rhijnvanderweel-art/O-en-o-suikerziekte-3d-model/images/back_side.png

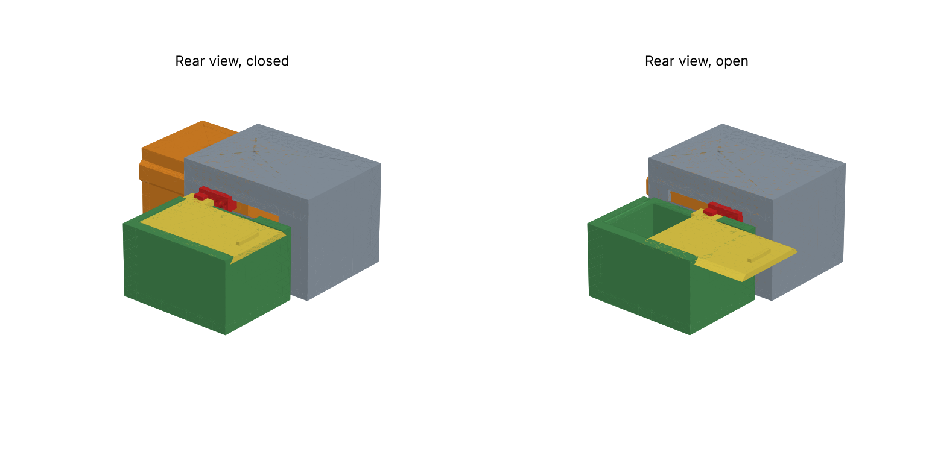
images/back_side.png
