rhijnvanderweel-art/O-en-o-suikerziekte-3d-model/images/top.png

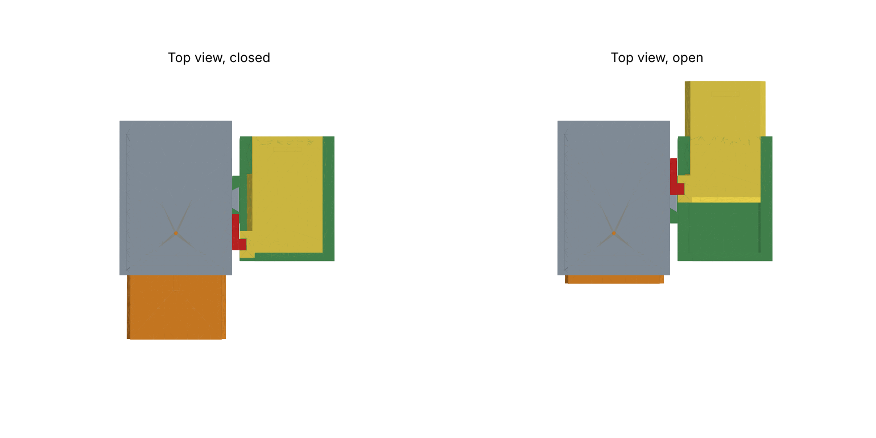
images/top.png
