rhijnvanderweel-art/O-en-o-suikerziekte-3d-model/step/assembly_open.step

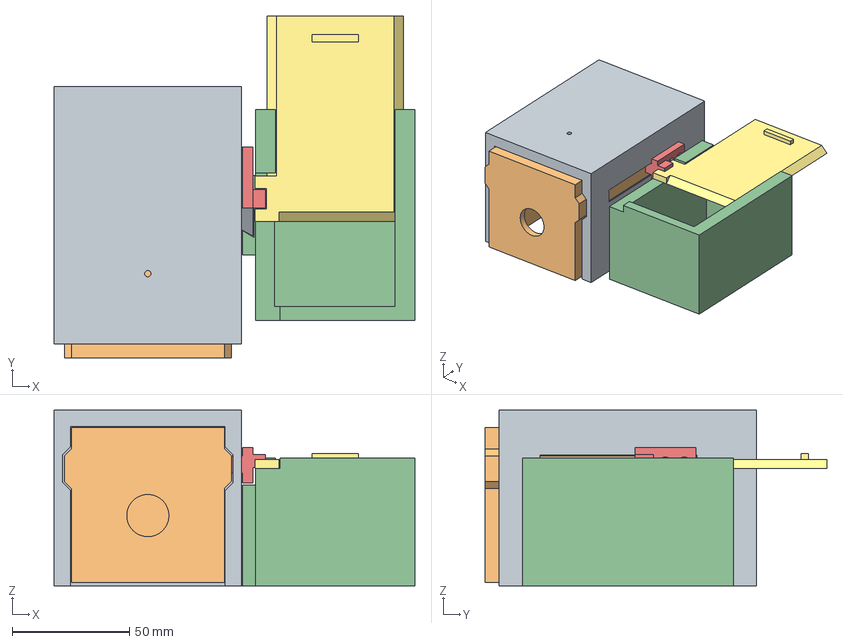
[picture p5: CAD file, 2026-11-12]
step/assembly_open.step
154.0 x 146.0 x 75.0 mm
driver
bin
lid
