rhijnvanderweel-art/O-en-o-suikerziekte-3d-model/step/assembly_closed.step

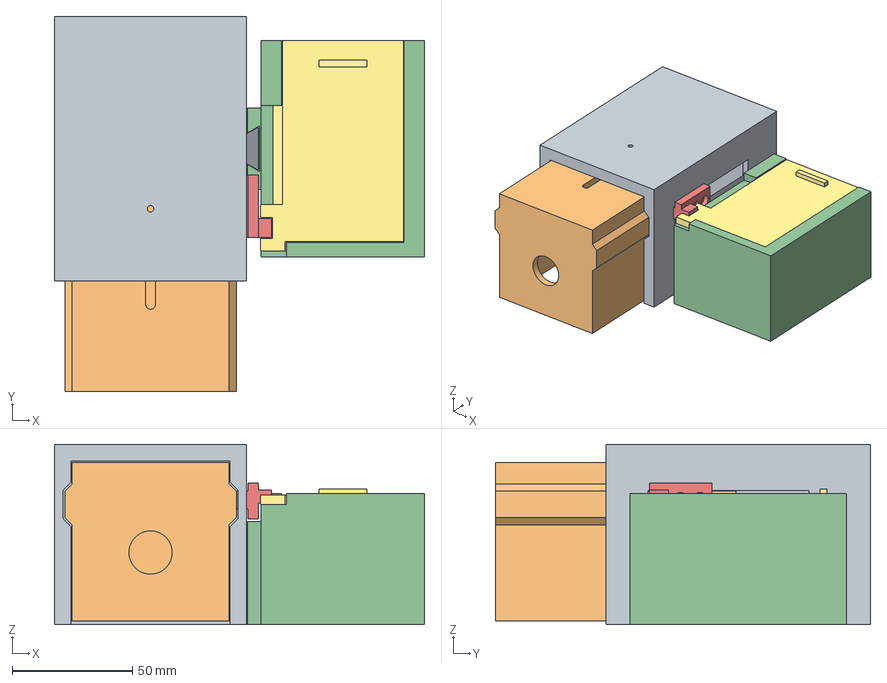
[picture p6: CAD file, 2026-11-12]
step/assembly_closed.step
154.0 x 156.0 x 75.0 mm
driver
bin
lid
