rhijnvanderweel-art/O-en-o-suikerziekte-3d-model/stl/3_driver.stl

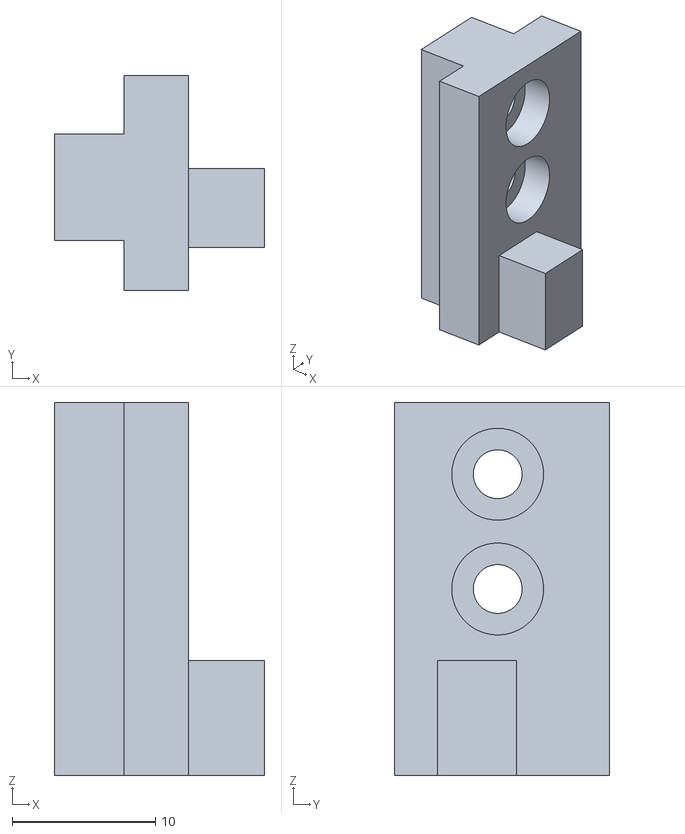
[picture p7: CAD file, 2026-11-12]
stl/3_driver.stl
14.6 x 15.0 x 26.0
