rhijnvanderweel-art/O-en-o-suikerziekte-3d-model/stl/4_bin.stl

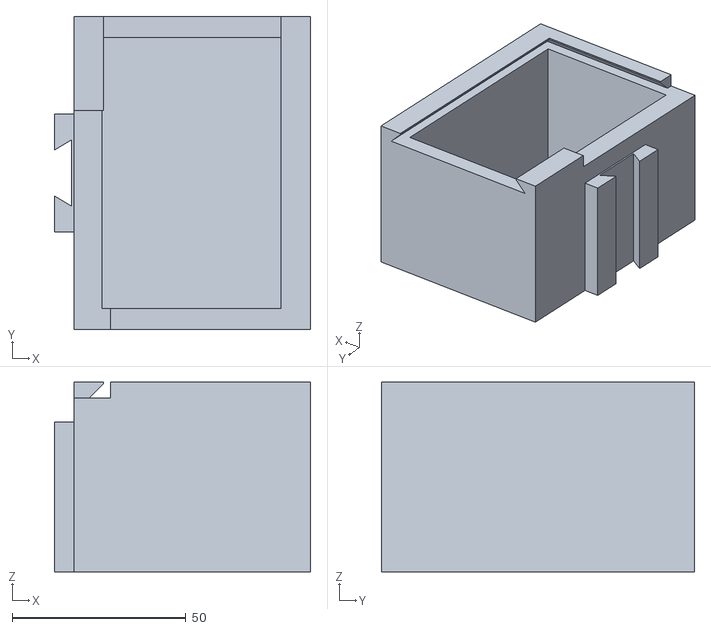
[picture p8: CAD file, 2026-11-12]
stl/4_bin.stl
73.6 x 90.0 x 54.5
