rhijnvanderweel-art/O-en-o-suikerziekte-3d-model/stl/1_shell.stl

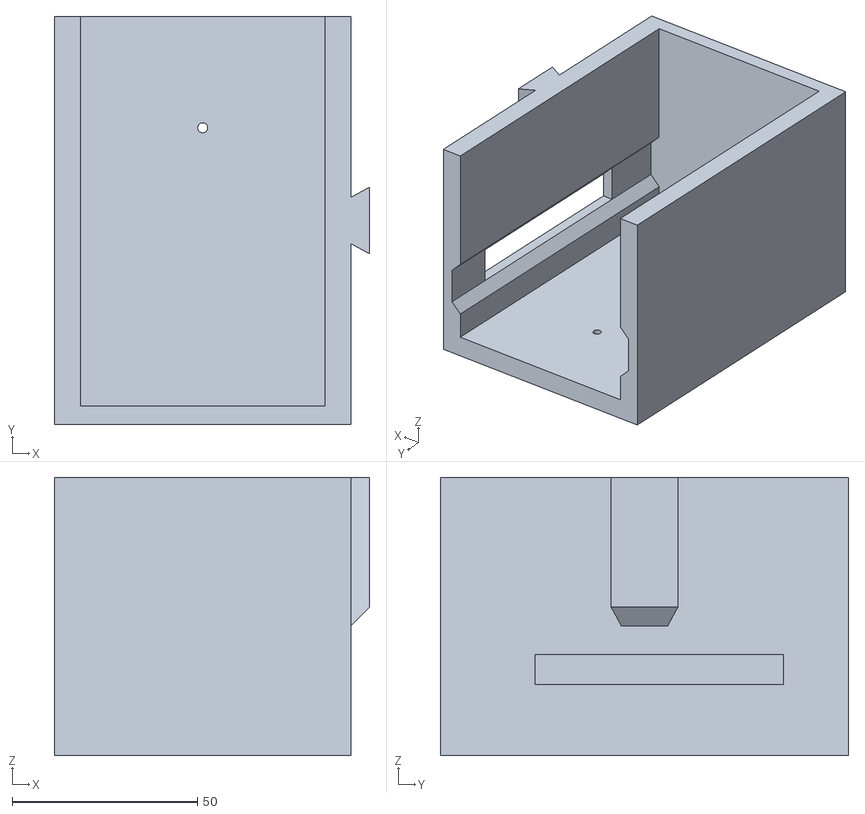
[picture p9: CAD file, 2026-11-12]
stl/1_shell.stl
85.0 x 110.0 x 75.0
