rhijnvanderweel-art/O-en-o-suikerziekte-3d-model/stl/2_box.stl

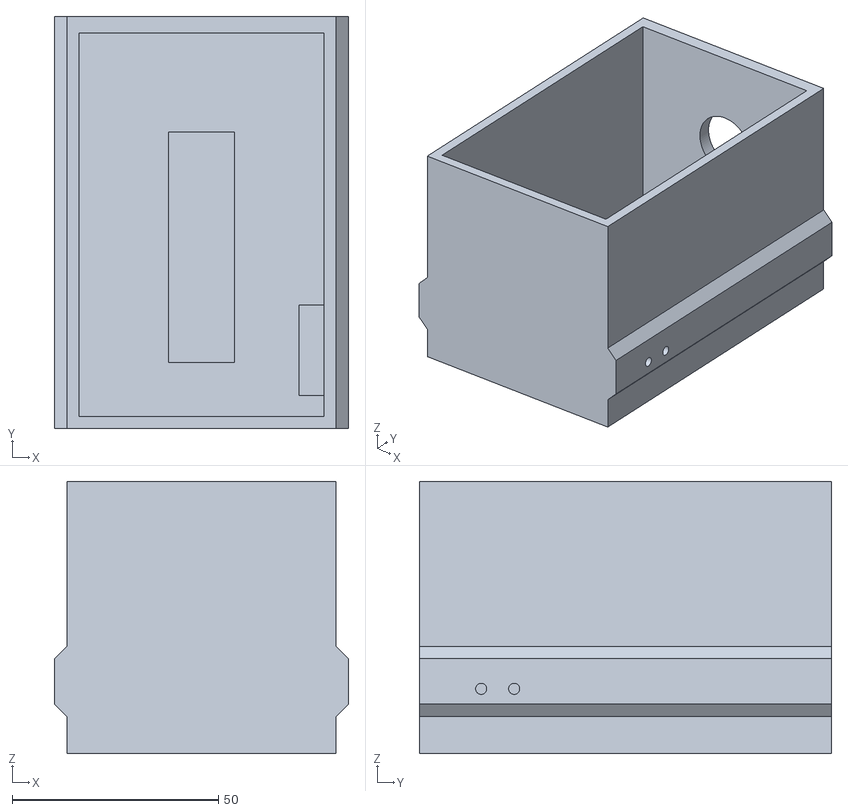
[picture p10: CAD file, 2026-11-12]
stl/2_box.stl
71.3 x 100.0 x 66.0
