rhijnvanderweel-art/O-en-o-suikerziekte-3d-model/stl/5_lid.stl

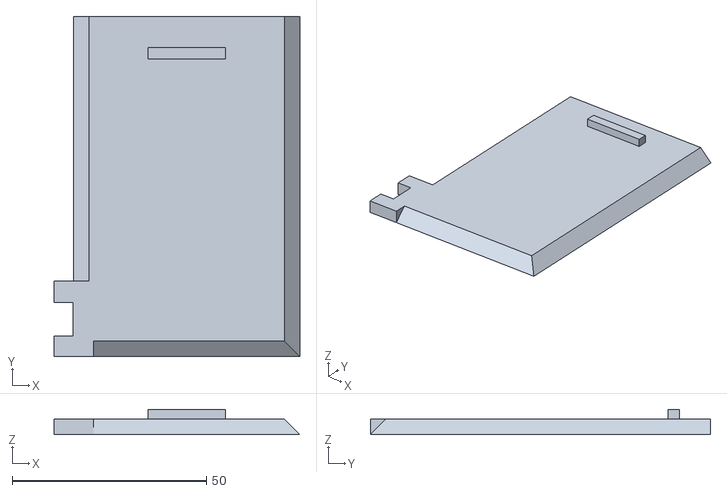
[picture p11: CAD file, 2026-11-12]
stl/5_lid.stl
63.3 x 87.7 x 6.50
