rhijnvanderweel-art/O-en-o-suikerziekte-3d-model/(commit log)

2026-11-12 Add printable donkey feeding station model
    Shell, push box on rails, driver block, food bin and sliding lid,
    generated by a parametric CadQuery script with fit checks.
    Claude-Session: https://claude.ai/code/session_01UFwJdKfzmwv19pVpptVw7z
    [1_shell.stl, 2_box.stl, 3_driver.stl, 4_bin.stl, 5_lid.stl, assembly_closed.step, assembly_open.step]
2026-11-12 Clarify README note about the wall slot
    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
